0x007E/cjb/mechanical/housing.FCStd

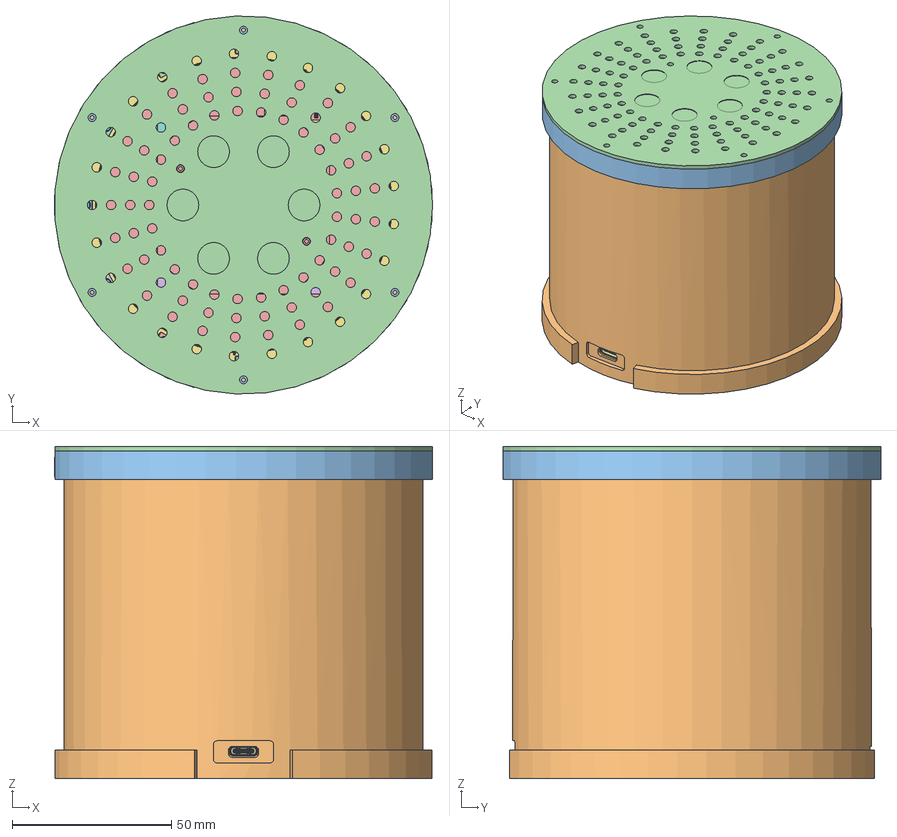
[picture p1: CAD file, 2026-04-10]
mechanical/housing.FCStd
118.9 x 118.8 x 104.5 mm
Pcb_84f1
R6_R_1206_3216Metric_b8ea6ec34850
R2_R_1206_3216Metric_b3acf86c6a30
R10_R_1206_3216Metric_fee79024a377
R8_R_1206_3216Metric_339db8180c64
C1_C_1206_3216Metric_12c8d903e841
R3_R_1206_3216Metric_83833871624d
R4_R_1206_3216Metric_442d5b8a35f1
R5_R_1206_3216Metric_4848958c9431
U1_SOIC-14_3.9x8.7mm_P1.27mm_35921325ff5e
R9_R_1206_3216Metric_88e3ba4c58bd
R7_R_1206_3216Metric_a49d56fa997f
J7_PinHeader_1x06_P254mm_Vertical_SMD_Pin1Left_1285e679425b
R1_R_1206_3216Metric_ab4ac080a6bd
Pcb_ce7c
C18_CP_Elec_63x52_805987101a73
R1_R_1206_3216Metric_3deb2a82df4c
R11_R_1206_3216Metric_e16db49a5ab9
C13_CP_Elec_5x53_7fb168ed10d8
D15_LED_RGB_5050_6_e2fea9b84616
C29_C_1206_3216Metric_bcb139b74633
R14_R_1206_3216Metric_1c3113596d5c
C35_C_1206_3216Metric_770a86e51b38
R12_R_1206_3216Metric_ee79d247b04f
D8_LED_RGB_5050_6_b18003341172
C24_CP_Elec_63x52_e8cae81e7b7b
C30_C_1206_3216Metric_562874c6d67a
C39_C_1206_3216Metric_e57f1ea64c44
SW3_1_96ba15551e7e
C36_C_1206_3216Metric_e78c4690f926
D9_LED_RGB_5050_6_3a1b03cabd13
D10_LED_RGB_5050_6_4ade68251821
C41_C_1206_3216Metric_fb4ec38e9715
SW2_1_08434e0c05de
C9_C_1206_3216Metric_940776f5537a
U4_ESP32-WROOM-32U_595d5ef36f0c
J5_PinHeader_1x02_P254mm_Vertical_5382f7fa877a
R19_R_1206_3216Metric_00e5d5f28e0f
C16_C_1206_3216Metric_3eff815542ad
R18_R_1206_3216Metric_81823283bd99
C38_C_1206_3216Metric_25a6ba5e8e4f
R16_R_1206_3216Metric_18d0a406f554
C8_C_1206_3216Metric_51bfaff74b79
SW1_PinHeader_1x03_P254mm_Vertical_ebe121ea7359
D4_LED_RGB_5050_6_e786f008e974
C31_C_1206_3216Metric_911d91d987eb
LS2_TerminalBlock_Phoenix_MKDS_15_2_508_1x02_P508mm_Horizontal_1a020b7471ea
C40_C_1206_3216Metric_936caa523b8c
C34_C_1206_3216Metric_30080eb9fb02
R10_R_1206_3216Metric_c31957a7baa1
R26_R_1206_3216Metric_6618ce29d65d
C99_C_1206_3216Metric_355cd3aa0eb8
D11_LED_RGB_5050_6_1de642d3dd5f
R22_R_1206_3216Metric_bc0a7f61bcfa
C28_CP_Elec_63x52_03db3facbf8c
C32_C_1206_3216Metric_e4d58b96d0d9
J3_PinSocket_1x06_P2.54mm_Vertical_c8ebd58055e8
C12_C_1206_3216Metric_e991a4a2ae73
D6_LED_RGB_5050_6_dfd5704b85f2
C4_CP_Elec_63x52_59d0d3e3084f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
