0x007E/cjb/pcb/CJB.kicad_pcb

## KiCad design pcb/CJB.kicad_pcb (2026-04-08)

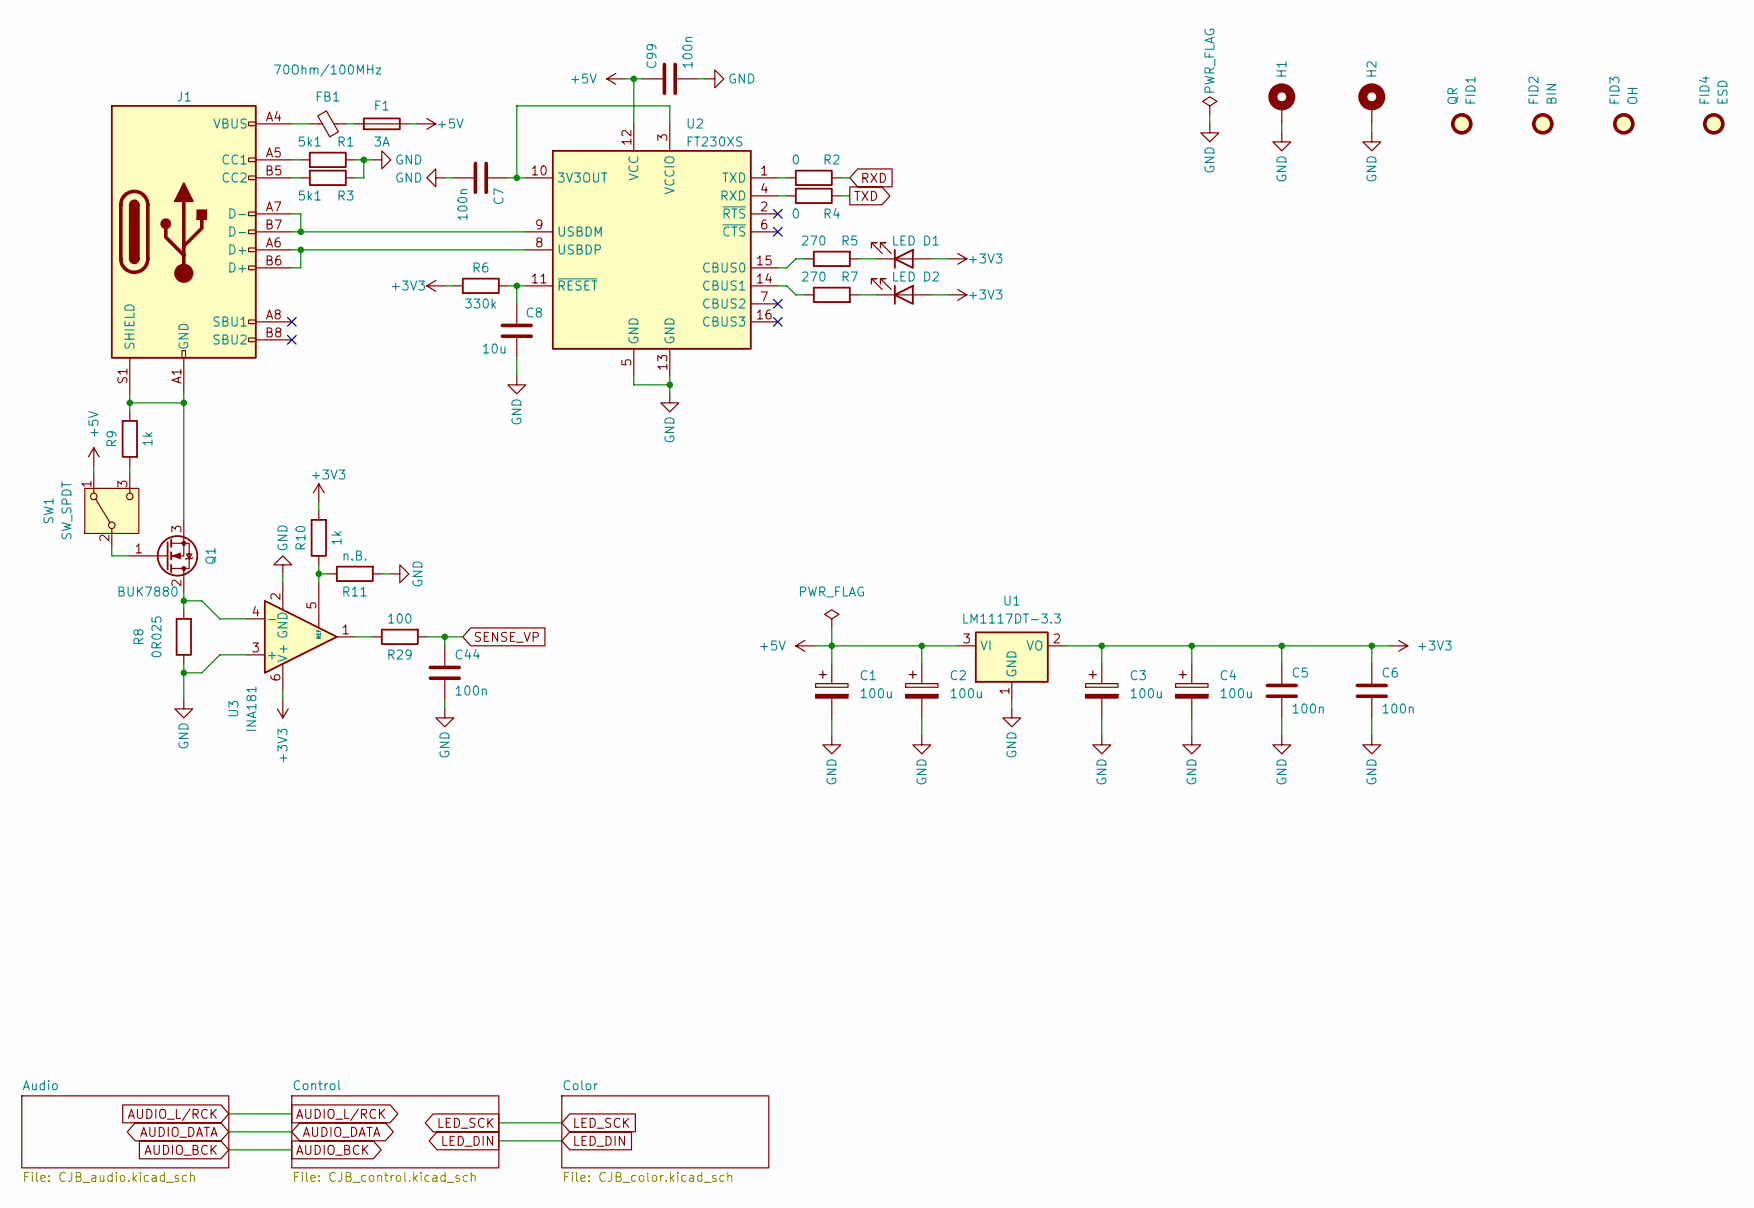
[picture p2: schematic CJB.kicad_sch, ${acronym} - ${title}]

Parts:
C1, C2, C3, C4: 100u; CP_Elec_6.3x5.2
C5, C6, C7, C44, C99: 100n; C_1206_3216Metric
C8: 10u; C_1206_3216Metric
D1, D2: LED; LED_1206_3216Metric
F1: 3A; Fuse_1206_3216Metric
FB1: 70Ohm/100MHz; L_1206_3216Metric
FID1: QR; QR_0x007e_small
FID2: BIN; WEEE-Logo_4.2x6mm_SilkScreen
FID3: OH; OSHW-Logo2_7.3x6mm_SilkScreen
FID4: ESD; ESD-Logo_6.6x6mm_SilkScreen
H1, H2: MountingHole_Pad; MountingHole_3.2mm_M3_DIN965_Pad
J1: USB_C_Receptacle_USB2.0_16P; USB_C_Receptacle_GCT_USB4110
Q1: BUK7880; SOT-223-3_TabPin2
R1, R3: 5k1; R_1206_3216Metric
R2, R4: 0; R_1206_3216Metric
R5, R7: 270; R_1206_3216Metric
R6: 330k; R_1206_3216Metric
R8: 0R025; R_2010_5025Metric
R9, R10: 1k; R_1206_3216Metric
R11: n.B.; R_1206_3216Metric
R29: 100; R_1206_3216Metric
SW1: SW_SPDT; PinHeader_1x03_P2.54mm_Vertical
U1: LM1117DT-3.3; TO-252-3_TabPin2
U2: FT230XS; SSOP-16_3.9x4.9mm_P0.635mm
U3: INA181; SOT-23-6

Connections:
+3V3: C3.1, C4.1, C5.2, C6.2, D1.2 (A), D2.2 (A), R6.2, R10.2, U1.2 (VO), U3.6 (V+); also elsewhere on the board
+5V: C1.1, C2.1, C99.2, F1.1, SW1.1 (A), U1.3 (VI), U2.12 (VCC); also elsewhere on the board
GND: C1.2, C2.2, C3.2, C4.2, C5.1, C6.1, C7.1, C8.1, C44.1, C99.1, H1.1, H2.1, R1.1, R3.1, R8.1, R11.2, U1.1 (GND), U2.5 (GND), U2.13 (GND), U3.2 (GND), U3.3 (+); also elsewhere on the board
unnamed: D1.1 (K), R5.2
unnamed: D2.1 (K), R7.2
unnamed: F1.2, FB1.1
unnamed: FB1.2, J1.A4 (VBUS), J1.A9 (VBUS), J1.B4 (VBUS), J1.B9 (VBUS)
unnamed: J1.A5 (CC1), R1.2
unnamed: J1.B5 (CC2), R3.2
unnamed: J1.A1 (GND), J1.A12 (GND), J1.B1 (GND), J1.B12 (GND), J1.S1 (SHIELD), Q1.3 (S), R9.1
unnamed: Q1.2 (D), R8.2, U3.4 (-)
unnamed: Q1.1 (G), SW1.2 (B)
unnamed: R29.1, U3.1
unnamed: R9.2, SW1.3 (C)
unnamed: C7.2, U2.3 (VCCIO), U2.10 (3V3OUT)
unnamed: R5.1, U2.15 (CBUS0)
unnamed: R7.1, U2.14 (CBUS1)
unnamed: R4.2, U2.4 (RXD)
unnamed: R2.2, U2.1 (TXD)
unnamed: J1.A7 (D-), J1.B7 (D-), U2.9 (USBDM)
unnamed: J1.A6 (D+), J1.B6 (D+), U2.8 (USBDP)
unnamed: C8.2, R6.1, U2.11 (~RESET)
unnamed: R10.1, R11.1, U3.5 (REF)
RXD: R2.1; also elsewhere on the board
SENSE_VP: C44.2, R29.2; also elsewhere on the board
TXD: R4.1; also elsewhere on the board

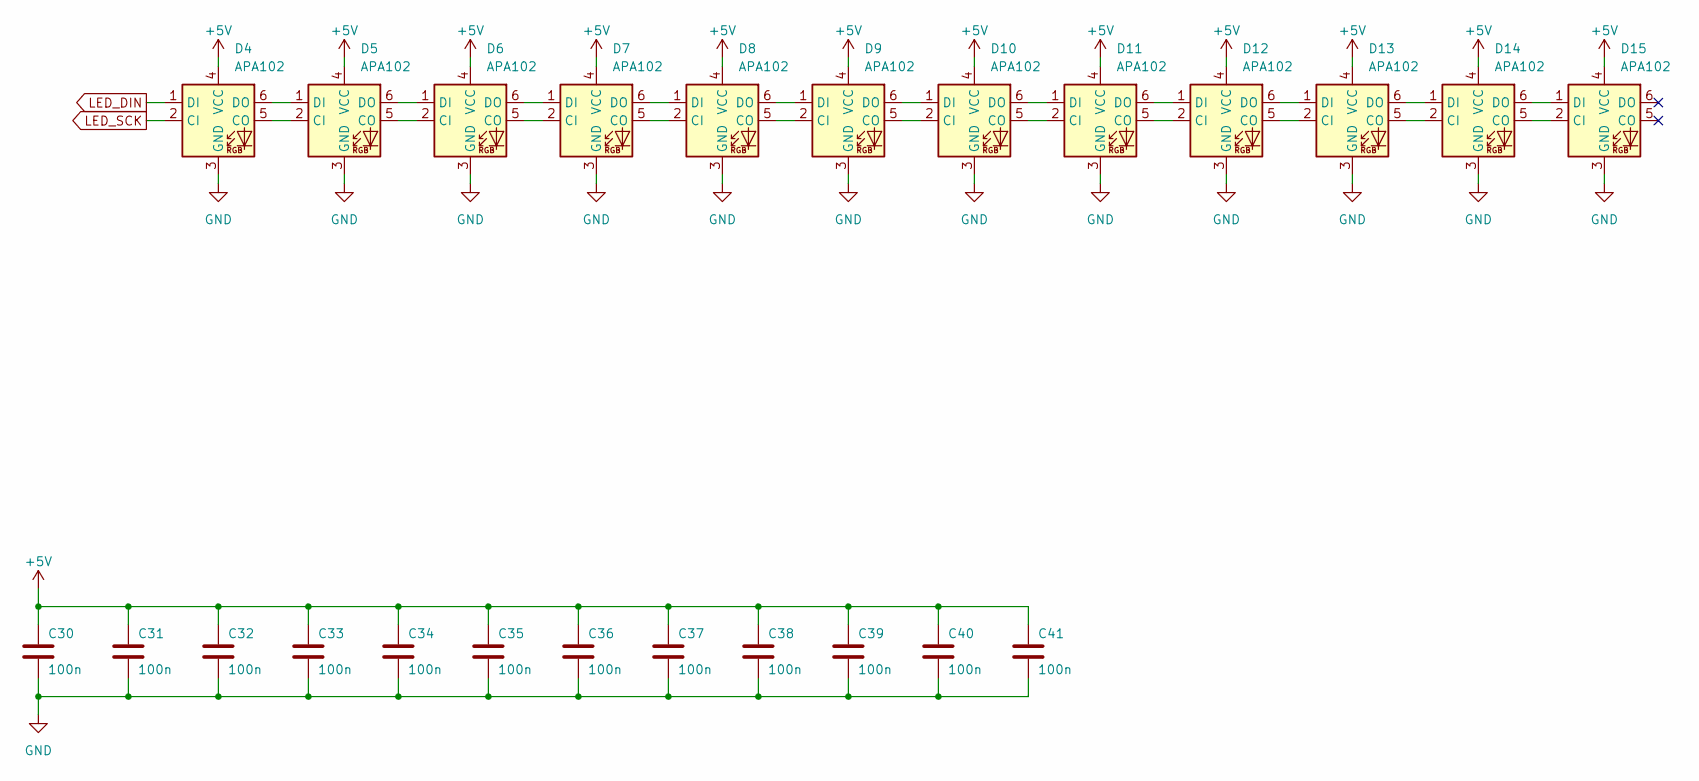
[picture p3: schematic CJB_color.kicad_sch, ${acronym} - ${title}]

Parts:
C30, C31, C32, C33, C34, C35, C36, C37, C38, C39, C40, C41: 100n; C_1206_3216Metric
D4, D5, D6, D7, D8, D9, D10, D11, D12, D13, D14, D15: APA102; LED_RGB_5050-6

Connections:
+5V: C30.2, C31.2, C32.2, C33.2, C34.2, C35.2, C36.2, C37.2, C38.2, C39.2, C40.2, C41.2, D4.4 (VCC), D5.4 (VCC), D6.4 (VCC), D7.4 (VCC), D8.4 (VCC), D9.4 (VCC), D10.4 (VCC), D11.4 (VCC), D12.4 (VCC), D13.4 (VCC), D14.4 (VCC), D15.4 (VCC); also elsewhere on the board
GND: C30.1, C31.1, C32.1, C33.1, C34.1, C35.1, C36.1, C37.1, C38.1, C39.1, C40.1, C41.1, D4.3 (GND), D5.3 (GND), D6.3 (GND), D7.3 (GND), D8.3 (GND), D9.3 (GND), D10.3 (GND), D11.3 (GND), D12.3 (GND), D13.3 (GND), D14.3 (GND), D15.3 (GND); also elsewhere on the board
LED_DIN: D4.1 (DI); also elsewhere on the board
LED_SCK: D4.2 (CI); also elsewhere on the board
unnamed: D4.5 (CO), D5.2 (CI)
unnamed: D4.6 (DO), D5.1 (DI)
unnamed: D5.5 (CO), D6.2 (CI)
unnamed: D5.6 (DO), D6.1 (DI)
unnamed: D6.5 (CO), D7.2 (CI)
unnamed: D6.6 (DO), D7.1 (DI)
unnamed: D7.5 (CO), D8.2 (CI)
unnamed: D7.6 (DO), D8.1 (DI)
unnamed: D8.5 (CO), D9.2 (CI)
unnamed: D8.6 (DO), D9.1 (DI)
unnamed: D9.5 (CO), D10.2 (CI)
unnamed: D10.5 (CO), D11.2 (CI)
unnamed: D9.6 (DO), D10.1 (DI)
unnamed: D10.6 (DO), D11.1 (DI)
unnamed: D11.5 (CO), D12.2 (CI)
unnamed: D11.6 (DO), D12.1 (DI)
unnamed: D12.5 (CO), D13.2 (CI)
unnamed: D12.6 (DO), D13.1 (DI)
unnamed: D13.5 (CO), D14.2 (CI)
unnamed: D13.6 (DO), D14.1 (DI)
unnamed: D14.5 (CO), D15.2 (CI)
unnamed: D14.6 (DO), D15.1 (DI)

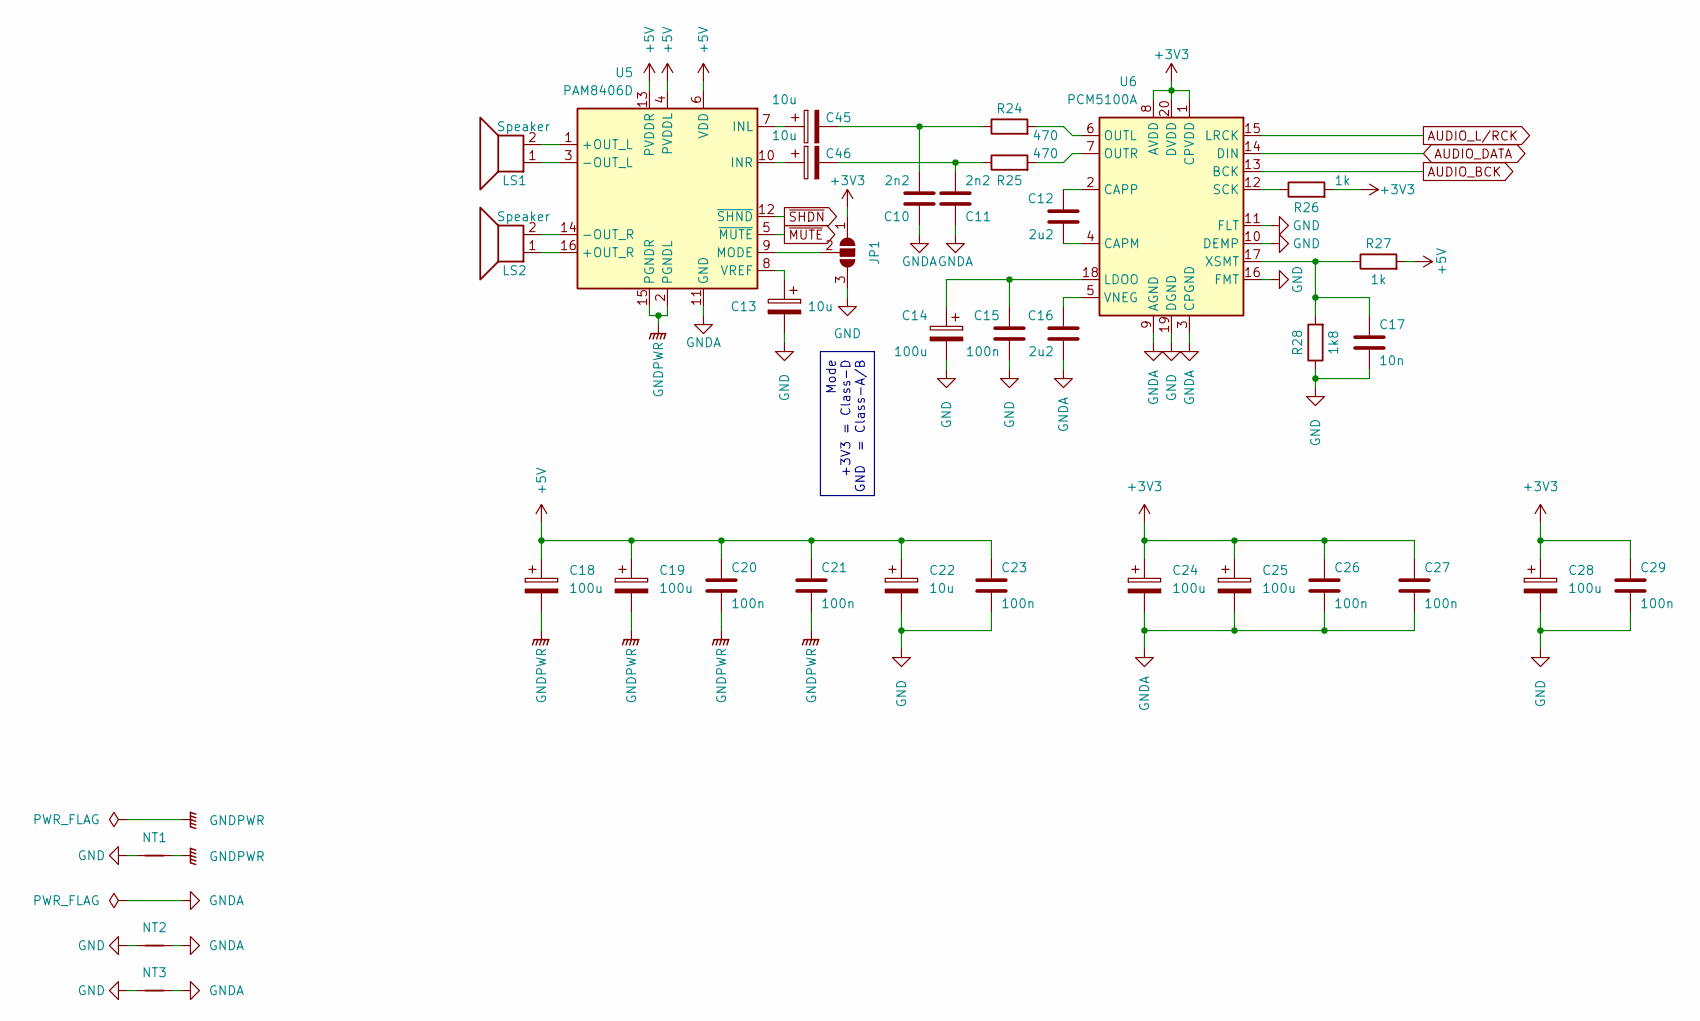
[picture p4: schematic CJB_audio.kicad_sch, ${acronym} - ${title}]

Parts:
C10, C11: 2n2; C_1206_3216Metric
C12, C16: 2u2; C_1206_3216Metric
C13, C22, C45, C46: 10u; CP_Elec_5x5.3
C14, C18, C19, C24, C25, C28: 100u; CP_Elec_6.3x5.2
C15, C20, C21, C23, C26, C27, C29: 100n; C_1206_3216Metric
C17: 10n; C_1206_3216Metric
JP1: SolderJumper_3_Open; SolderJumper-3_P1.3mm_Open_Pad1.0x1.5mm_NumberLabels
LS1, LS2: Speaker; TerminalBlock_Phoenix_MKDS-1,5-2-5.08_1x02_P5.08mm_Horizont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
NT1, NT2, NT3: NetTie_2; NetTie-2_SMD_Pad2.0mm
R24, R25: 470; R_1206_3216Metric
R26, R27: 1k; R_1206_3216Metric
R28: 1k8; R_1206_3216Metric
U5: PAM8406D; SOIC-16_3.9x9.9mm_P1.27mm
U6: PCM5100A; TSSOP-20_4.4x6.5mm_P0.65mm

Connections:
+3V3: C24.1, C25.1, C26.2, C27.2, C28.1, C29.2, JP1.1 (A), R26.2, U6.1 (CPVDD), U6.8 (AVDD), U6.20 (DVDD); also elsewhere on the board
+5V: C18.1, C19.1, C20.2, C21.2, C22.1, C23.2, R27.2, U5.4 (PVDDL), U5.6 (VDD), U5.13 (PVDDR); also elsewhere on the board
AUDIO_BCK: U6.13 (BCK); also elsewhere on the board
AUDIO_DATA: U6.14 (DIN); also elsewhere on the board
AUDIO_L/RCK: U6.15 (LRCK); also elsewhere on the board
GND: C13.2, C14.2, C15.1, C17.1, C22.2, C23.1, C28.2, C29.1, JP1.3 (B), NT1.1, NT2.1, NT3.1, R28.1, U6.10 (DEMP), U6.11 (FLT), U6.16 (FMT), U6.19 (DGND); also elsewhere on the board
GNDA: C10.2, C11.2, C16.1, C24.2, C25.2, C26.1, C27.1, NT2.2, NT3.2, U5.11 (GND), U6.3 (CPGND), U6.9 (AGND)
GNDPWR: C18.2, C19.2, C20.1, C21.1, NT1.2, U5.2 (PGNDL), U5.15 (PGNDR)
unnamed: C10.1, C45.2, R24.1
unnamed: C11.1, C46.2, R25.1
unnamed: JP1.2 (C), U5.9 (MODE)
unnamed: LS1.2, U5.1 (+OUT_L)
unnamed: LS2.1, U5.16 (+OUT_R)
unnamed: LS1.1, U5.3 (-OUT_L)
unnamed: LS2.2, U5.14 (-OUT_R)
unnamed: C45.1, U5.7 (INL)
unnamed: C46.1, U5.10 (INR)
unnamed: C13.1, U5.8 (VREF)
unnamed: C12.1, U6.4 (CAPM)
unnamed: C12.2, U6.2 (CAPP)
unnamed: C14.1, C15.2, U6.18 (LDOO)
unnamed: R24.2, U6.6 (OUTL)
unnamed: R25.2, U6.7 (OUTR)
unnamed: R26.1, U6.12 (SCK)
unnamed: C16.2, U6.5 (VNEG)
unnamed: C17.2, R27.1, R28.2, U6.17 (XSMT)
~MUTE: U5.5 (~MUTE); also elsewhere on the board
~SHDN: U5.12 (~SHND); also elsewhere on the board

Notes on the sheet:
Mode +3V3 = Class-D GND = Class-A/B

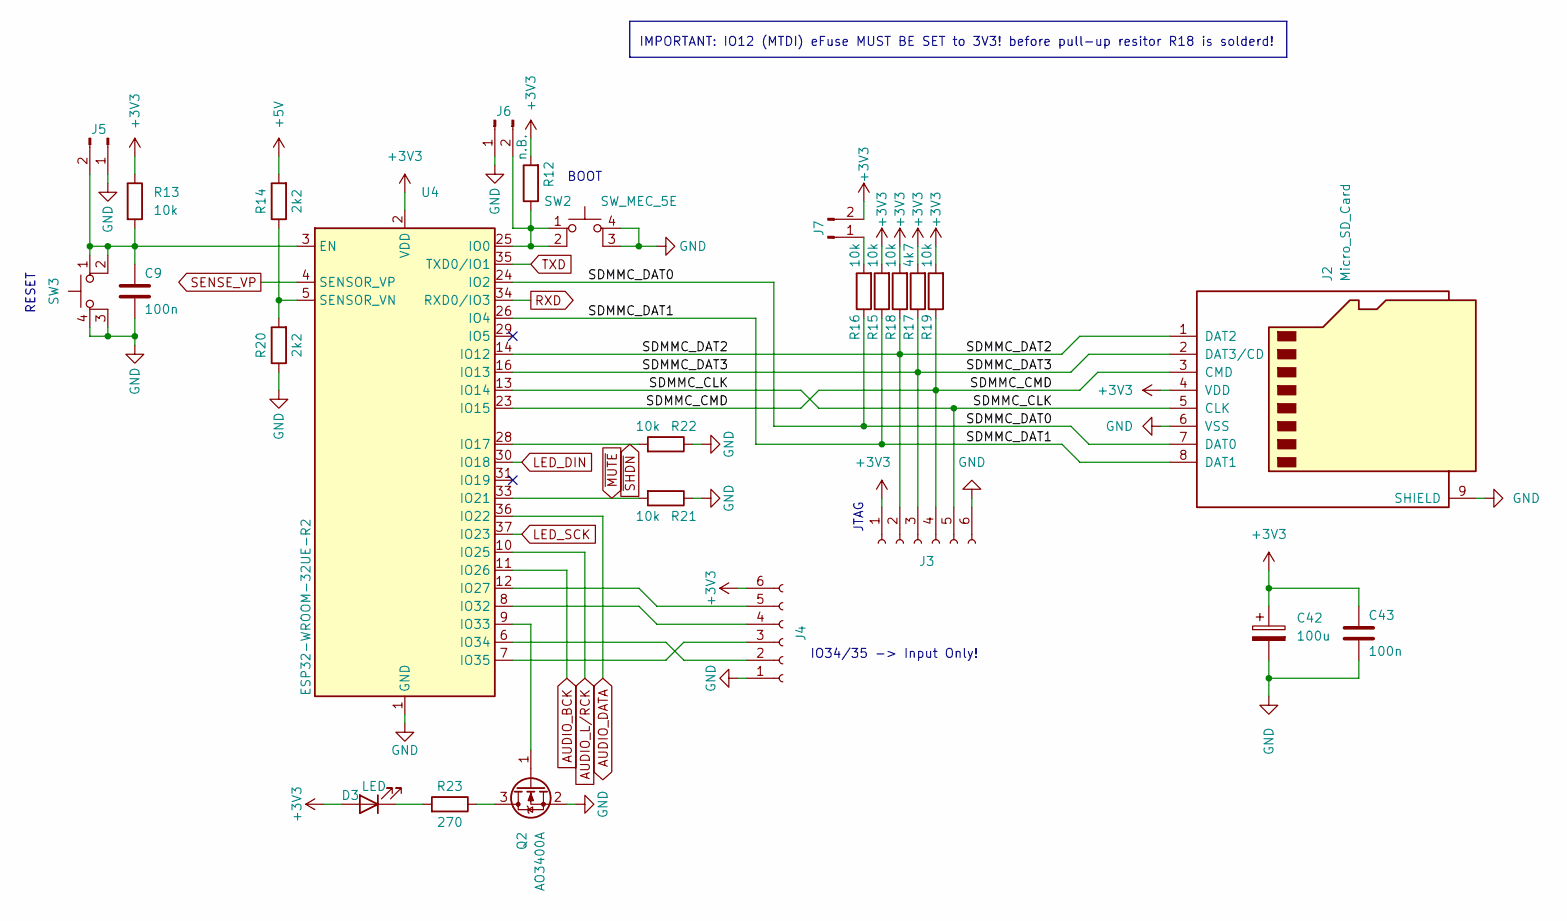
[picture p5: schematic CJB_control.kicad_sch, ${acronym} - ${title}]

Parts:
C9, C43: 100n; C_1206_3216Metric
C42: 100u; CP_Elec_6.3x5.2
D3: LED; LED_1206_3216Metric
J2: Micro_SD_Card; microSD_HC_Molex_47219-2001
J3, J4: Conn_01x06_Socket; PinSocket_1x06_P2.54mm_Vertical
J5, J6, J7: Conn_01x02_Pin; PinHeader_1x02_P2.54mm_Vertical
Q2: AO3400A; SOT-23
R12: n.B.; R_1206_3216Metric
R13, R15, R16, R18, R19, R21, R22: 10k; R_1206_3216Metric
R14, R20: 2k2; R_1206_3216Metric
R17: 4k7; R_1206_3216Metric
R23: 270; R_1206_3216Metric
SW2, SW3: SW_MEC_5E; SW_PTS530_GK055_SMTR_LFS
U4: ESP32-WROOM-32UE-R2; ESP32-WROOM-32U

Connections:
+3V3: C42.1, C43.2, D3.2 (A), J2.4 (VDD), J3.1, J4.6, J7.2, R12.2, R13.1, R15.2, R17.2, R18.2, R19.2, U4.2 (VDD); also elsewhere on the board
+5V: R14.2; also elsewhere on the board
/Control/SDMMC_CLK: J2.5 (CLK), J3.5, U4.13 (IO14)
/Control/SDMMC_CMD: J2.3 (CMD), J3.4, R19.1, U4.23 (IO15)
/Control/SDMMC_DAT0: J2.7 (DAT0), R16.1, U4.24 (IO2)
/Control/SDMMC_DAT1: J2.8 (DAT1), R15.1, U4.26 (IO4)
/Control/SDMMC_DAT2: J2.1 (DAT2), J3.2, R18.1, U4.14 (IO12)
/Control/SDMMC_DAT3: J2.2 (DAT3/CD), J3.3, R17.1, U4.16 (IO13)
AUDIO_BCK: U4.11 (IO26); also elsewhere on the board
AUDIO_DATA: U4.36 (IO22); also elsewhere on the board
AUDIO_L/RCK: U4.10 (IO25); also elsewhere on the board
GND: C9.1, C42.2, C43.1, J2.6 (VSS), J2.9 (SHIELD), J3.6, J4.1, J5.1, J6.1, Q2.2 (S), R20.1, R21.1, R22.1, SW2.3 (K), SW2.4 (A), SW3.3 (K), SW3.4 (A), U4.1 (GND), U4.15 (GND), U4.38 (GND), U4.39 (GND); also elsewhere on the board
LED_DIN: U4.30 (IO18); also elsewhere on the board
LED_SCK: U4.37 (IO23); also elsewhere on the board
unnamed: D3.1 (K), R23.2
unnamed: J4.2, U4.6 (IO34)
unnamed: J4.3, U4.7 (IO35)
unnamed: J4.4, U4.8 (IO32)
unnamed: J4.5, U4.12 (IO27)
unnamed: C9.2, J5.2, R13.2, SW3.1, SW3.2, U4.3 (EN)
unnamed: J6.2, R12.1, SW2.1, SW2.2, U4.25 (IO0)
unnamed: J7.1, R16.2
unnamed: Q2.3 (D), R23.1
unnamed: Q2.1 (G), U4.9 (IO33)
unnamed: R14.1, R20.2, U4.5 (SENSOR_VN)
RXD: U4.34 (RXD0/IO3); also elsewhere on the board
SENSE_VP: U4.4 (SENSOR_VP); also elsewhere on the board
TXD: U4.35 (TXD0/IO1); also elsewhere on the board
~MUTE: R21.2, U4.33 (IO21); also elsewhere on the board
~SHDN: R22.2, U4.28 (IO17); also elsewhere on the board

Notes on the sheet:
BOOT
IO34/35 -> Input Only!
RESET
JTAG
IMPORTANT: IO12 (MTDI) eFuse MUST BE SET to 3V3! before pull-up resitor R18 is solderd!

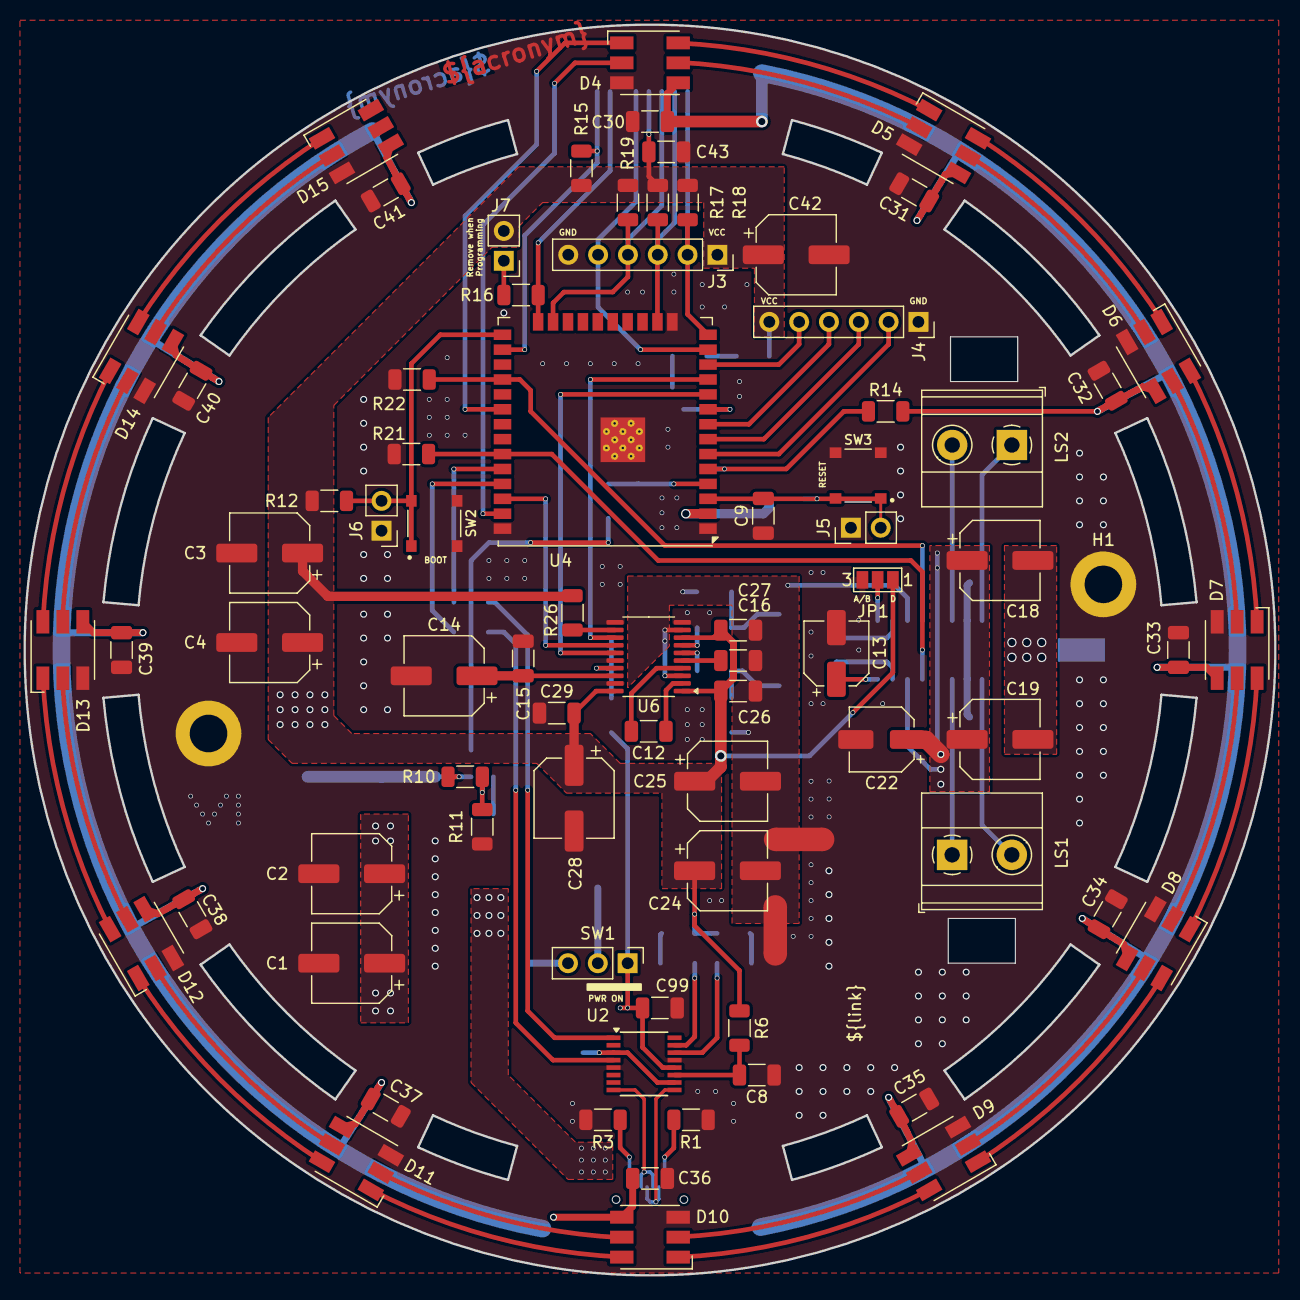
[picture p6: board CJB.kicad_pcb from above]

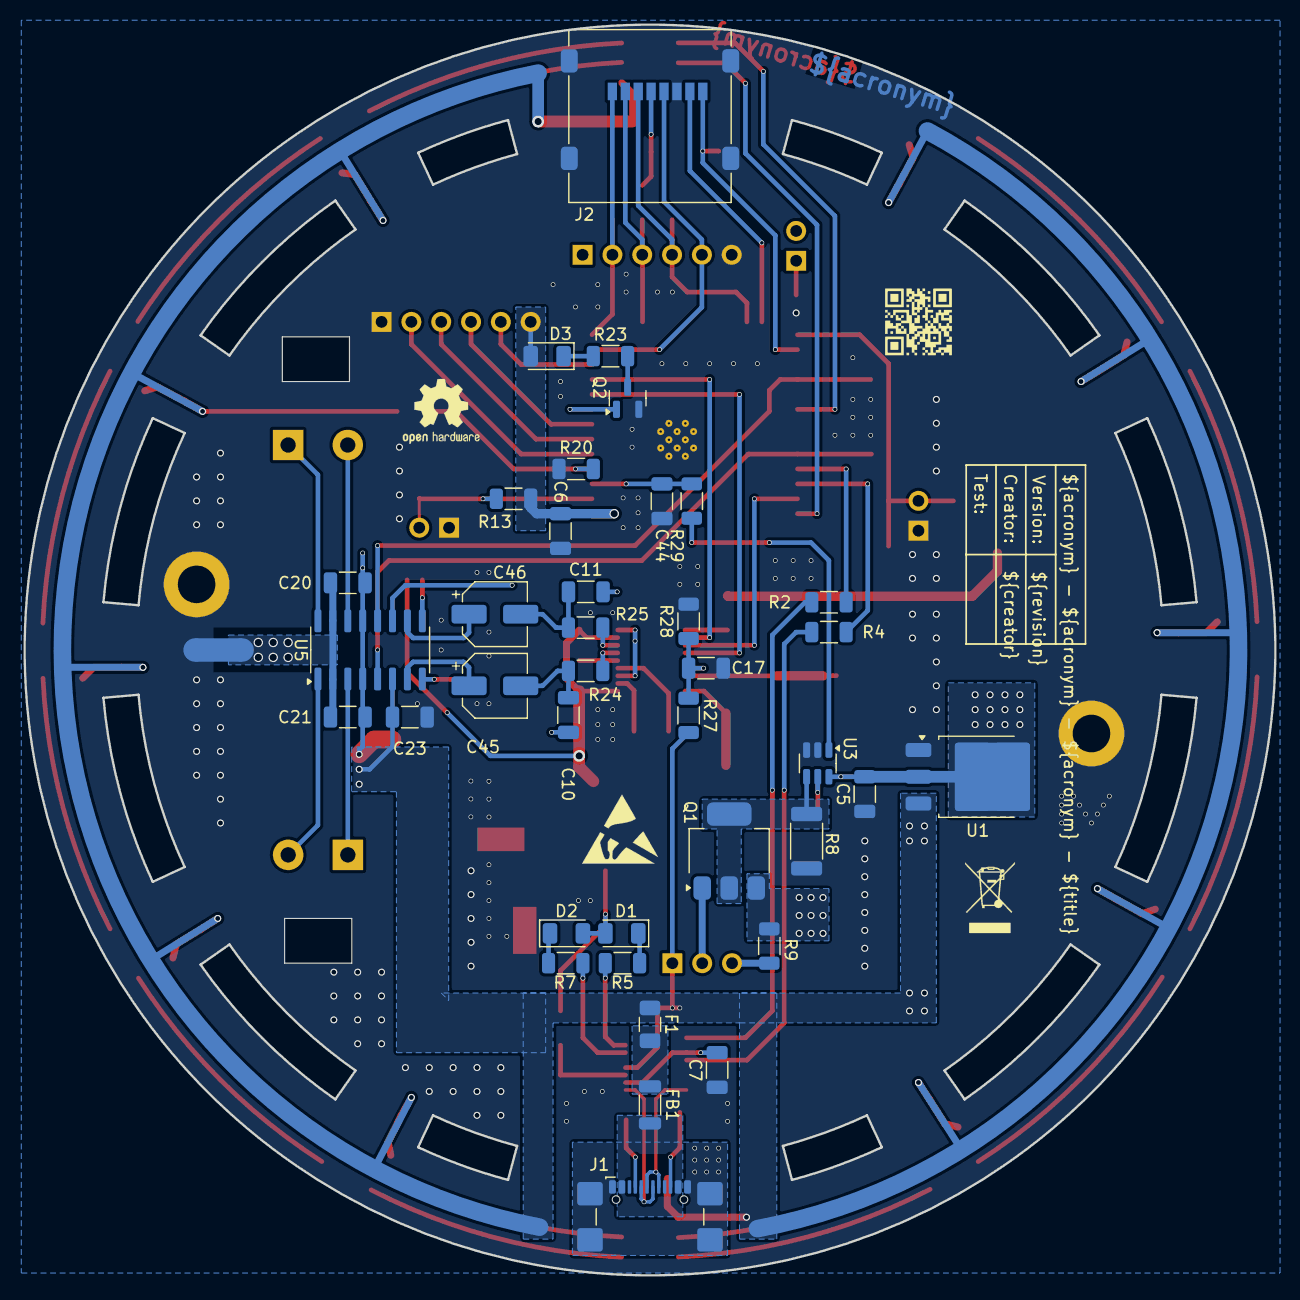
[picture p7: board CJB.kicad_pcb from below]

Board: 2 copper layers, 106.5 x 106.5 mm, 123 parts (43 on the bottom side), 92 nets.
