0x007E/cjb/(commit log)

2026-02-20 Add pcb layout
    [CJB.kicad_pcb, CJB.kicad_sch, CJB_audio.kicad_sch, CJB_color.kicad_sch, CJB_control.kicad_sch]
2026-03-04 Fix fabrication layer positions
    [CJB.kicad_pcb]
2026-03-04 Fix wrong vendor id
    [CJB.kicad_pcb, CJB_audio.kicad_sch]
2026-03-12 Change uart resistor values
    [CJB.kicad_pcb, CJB.kicad_sch]
2026-03-16 Add BOOT and RESET jumper
    [CJB.kicad_pcb, CJB_control.kicad_sch]
2026-03-27 Fix boot and power issue
    [CJB.kicad_pcb, CJB_audio.kicad_sch, CJB_control.kicad_sch]
2026-03-27 Change SHDN and MUTE pins
    [CJB.kicad_pcb, CJB_audio.kicad_sch, CJB_control.kicad_sch]
2026-03-27 Modify pcb position
    [CJB.kicad_pcb]
2026-03-27 Optimize silkscreen text
    [CJB.kicad_pcb]
2026-04-01 Add dimensioning
    [CJB.kicad_pcb]
2026-04-01 Add mechanical parts
    [housing.FCStd]
2026-04-01 Change env variables to upper case
2026-04-08 Rename apa102 spi clk/data pins
    [CJB.kicad_pcb, CJB_color.kicad_sch, CJB_control.kicad_sch]
2026-04-09 Reduce diameter of speaker plate
    [housing.FCStd]
2026-04-10 Adapt acrylglass screw hole diameter
    [housing.FCStd]
2026-04-10 Adapt mounting screw position of acrylglass and outer ring
    [housing.FCStd]
